BBBSnowball/energy-monitor/energy-meter/energy-meter-brd.pdf

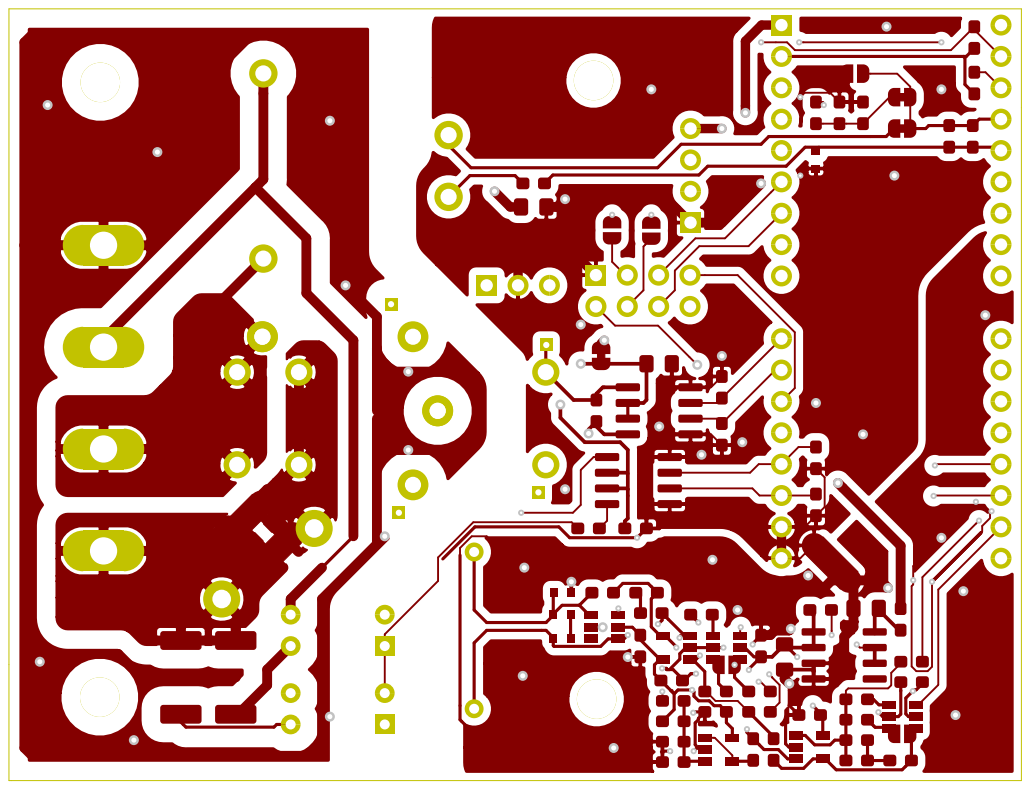
[picture p1: page 1]

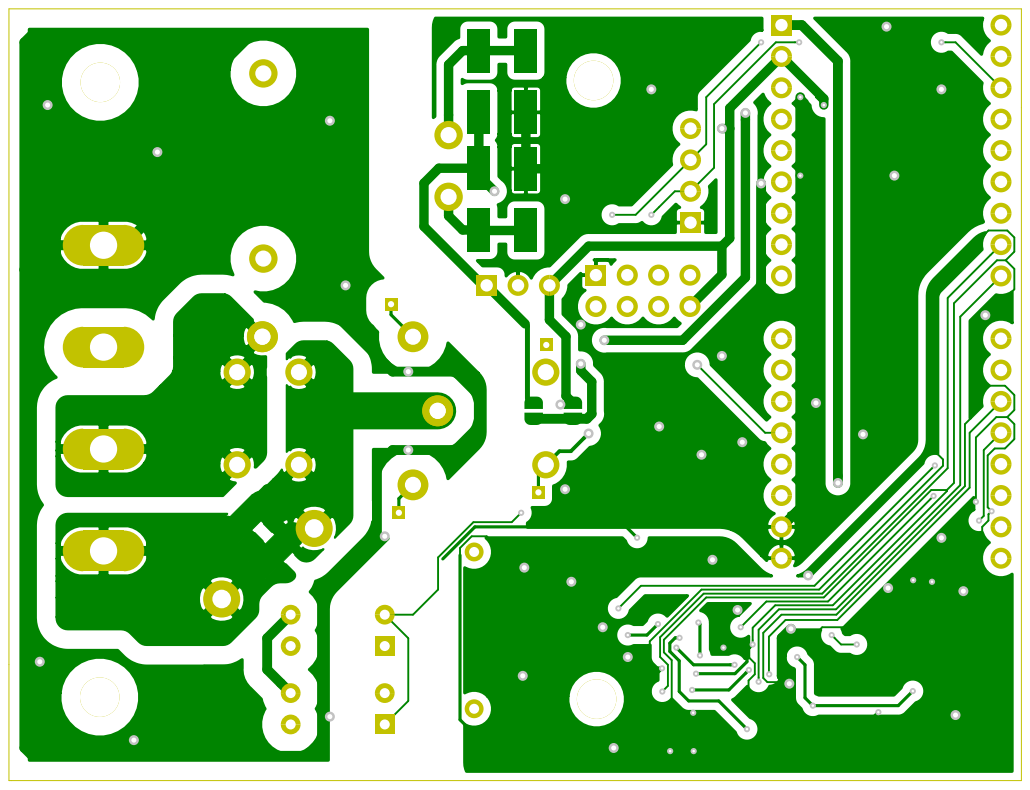
[picture p2: page 2]

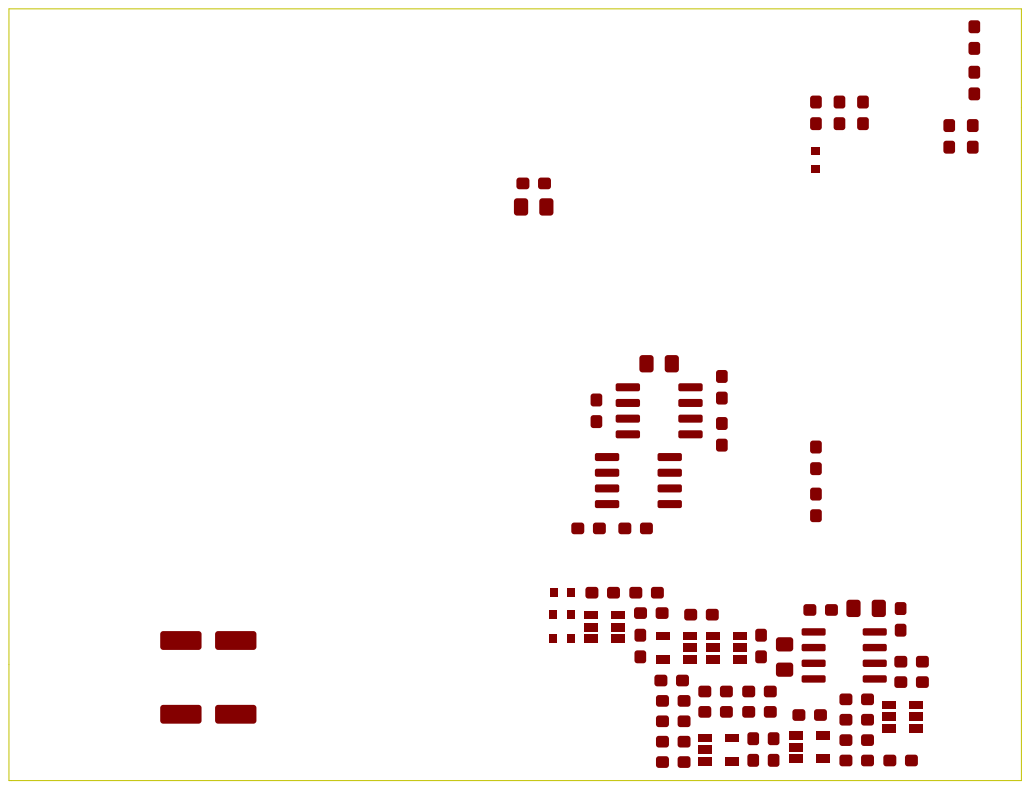
[picture p3: page 3]

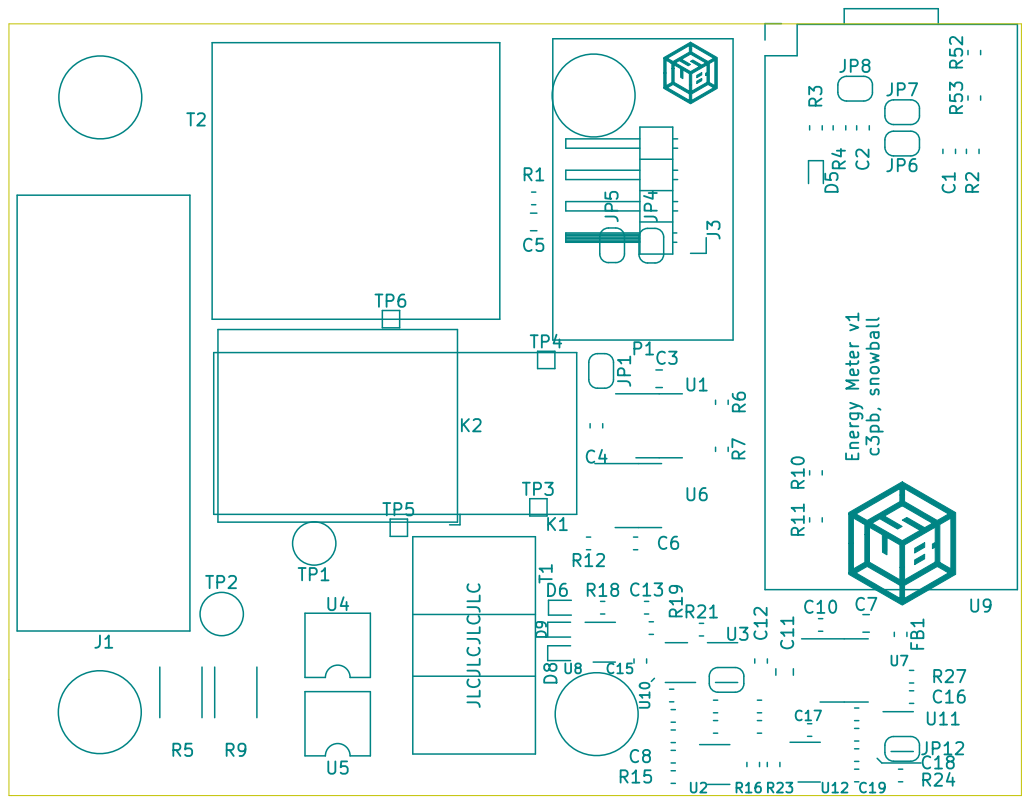
[picture p4: page 5]

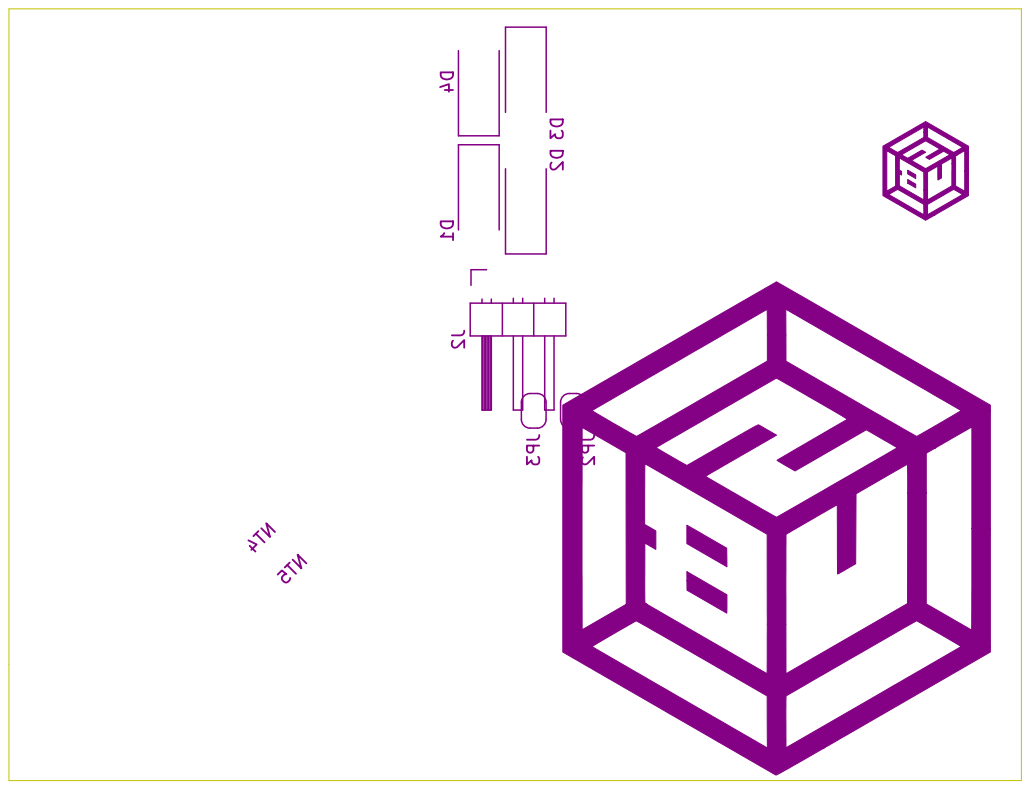
[picture p5: page 6]

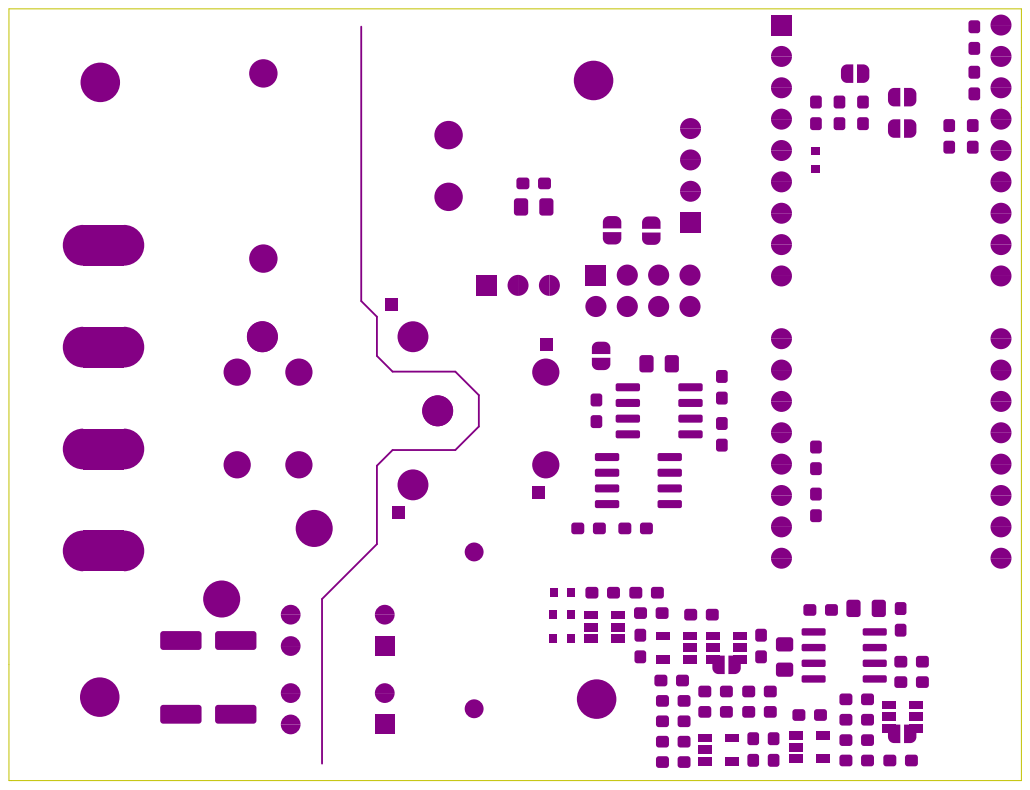
[picture p6: page 7]

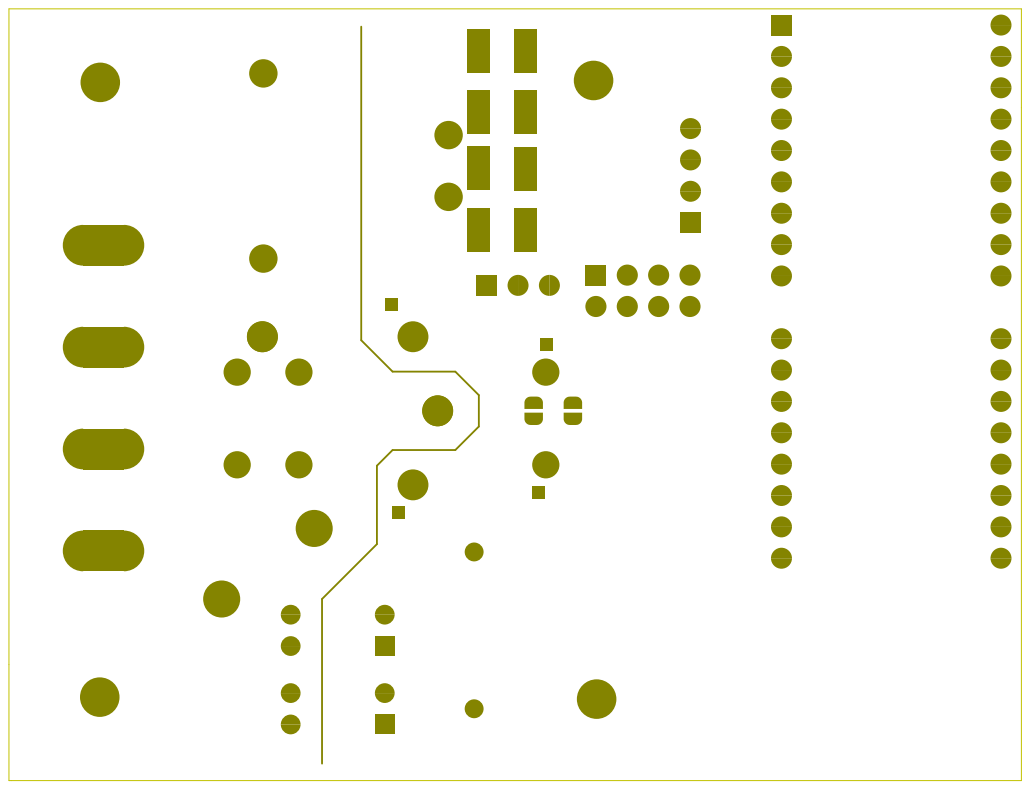
[picture p7: page 8]

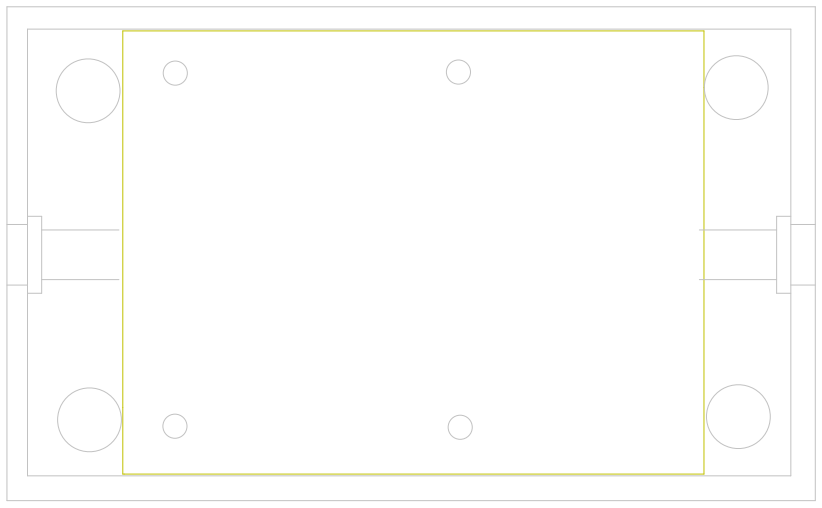
[picture p8: figure]
