BBBSnowball/energy-monitor/energy-meter/LTSpice/Current-Transformer3.asc

C1: cap; 6p
C2: cap; 0
C3: cap; 6p
C4: cap; 12p
I1: current; SINE(0 4u 50); AC 1u
R1: res; 10
R2: res; 10
R3: res; 10k
R4: res; 0
R5: res; 100k
R6: res; 1k
R7: res; 0
U1: AD8628
U2: AD8628
V1: voltage; 3.3
Named nets: VCC, 0, OUT, OUT2, BIAS
;tran 40m
.ac dec 10 1 100Meg
