BBBSnowball/energy-monitor/energy-meter/LTSpice/Current-Transformer.asc

C1: cap; 100n
C2: cap; 100n
C3: cap; 270p
D1: diode; 1N4148
D2: diode; 1N4148
D3: diode; 1N4148
D4: diode; 1N4148
D5: diode; 1N4148
D6: diode; 1N4148
D7: diode; 1N4148
E1: e; 1
E2: e; 1
I1: current; SINE(0 10 50)
I2: current; SINE(0 20 50)
I3: current; SINE(0 435u 50)
I4: current; SINE(0 1u 1k)
L1: ind2; 1n
L2: ind2; 6.25m
L3: ind2; 6.25m
L4: ind2; 1n
L5: ind2; 6.25m
L6: ind2; 1n
L7: ind2; 6.25m
L8: ind2; 1n
L9: ind2; 6.25m; Rser=330
L10: ind2; 1n
L11: ind2; 6.25m
L12: ind2; 1n
L13: ind; 470µ
M1: nmos; AO6408
M2: nmos; AO6408
R1: res; 500
R2: res; 50
R3: res; 50
R4: res; 220
R5: res; 1k
R6: res; 1k
R7: res; 10k
R8: res; 10k
R9: res; 2
R10: res; 0
R11: res; 50
R12: res; 220k
R13: res; 10k
R14: res; 10k
R15: res; 2
R16: res; 0
R17: res; 1Meg
R18: res; 1k
R19: res; 100k
R20: res; 10k
R21: res; 10k
R22: res; 2k
R23: res; 5k
R24: res; 3k
R25: res; 5k
R26: res; 3k
R27: res; 1k
R28: res; 1k
R29: res; 5k
R30: res; 5k
R31: res; 2k
R32: res; 2k
R33: res; 100k
R34: res; 1k
R35: res; 1k
U1: OP07
U2: AD8628
U3: AD8628
U4: ADA4528-1
U5: AD8628
U6: AD8628
U7: AD8628
U8: AD8628
U9: AD8628
V1: voltage; 15
V2: voltage; 15
V3: voltage; 5
V4: voltage; 3.3
V5: voltage; 2.01
V6: voltage; 3.3
V7: voltage; SINE(0 8.5 50)
V8: voltage; PULSE(0 3 0 0.1m 0.1m 9.9m 20m)
V9: voltage; PULSE(0 3 10m 0.1m 0.1m 9.9m 20m)
Named nets: -VCC, +VCC, 0, OUT, OUT2, OUT3, IN3, IN1, +5V, IN3B, OUT4, IN4, +3V3, IN4B, BIAS4, BIAS3, OUT2B, OUT5, IN5, BIAS5, OUT5B, VOUT6A, VOUT6B, VOUT7A, VOUT7B, VCC6, V7A, V7B, VOUT8, OUT5C
K1 L1 L2 1
.tran 100m
K2 L4 L3 1
K3 L6 L5 1
;.OPTIONS GMIN=100F
K4 L8 L7 1
K5 L9 L10 0.5
K6 L12 L11 1
0.1W
Measure voltage when also used for VCC
(not recommended)
use this one
GD32V pin
