BBBSnowball/energy-monitor/energy-meter/LTSpice/Current-Transformer2.asc

C1: cap; 100p
C2: cap; 100n
C3: cap; 270p
I3: current; SINE(0 435u 50)
I4: current; SINE(0 1u 500k)
L11: ind2; 6.25m
L12: ind2; 1n
L13: ind; 470µ
R1: res; 10
R12: res; 220k
R13: res; 10k
R14: res; 10k
R15: res; 2
R16: res; 0
R17: res; 1Meg
R18: res; 1k
R19: res; 100k
R33: res; 100k
R34: res; 1k
R35: res; 1k
U6: AD8628
U7: AD8628
U8: AD8628
V1: voltage; 3.3
V5: voltage; 2.15
Named nets: OUT5, IN5, 0, +3V3, BIAS5, OUT5B, OUT5C
K6 L12 L11 1
0.1W
GD32V pin
.tran 40m
;.ac dec 10 1 1Meg
