BBBSnowball/energy-monitor/energy-meter/energy-meter.kicad_pcb

## KiCad design energy-meter/energy-meter.kicad_pcb (2022-12-10)

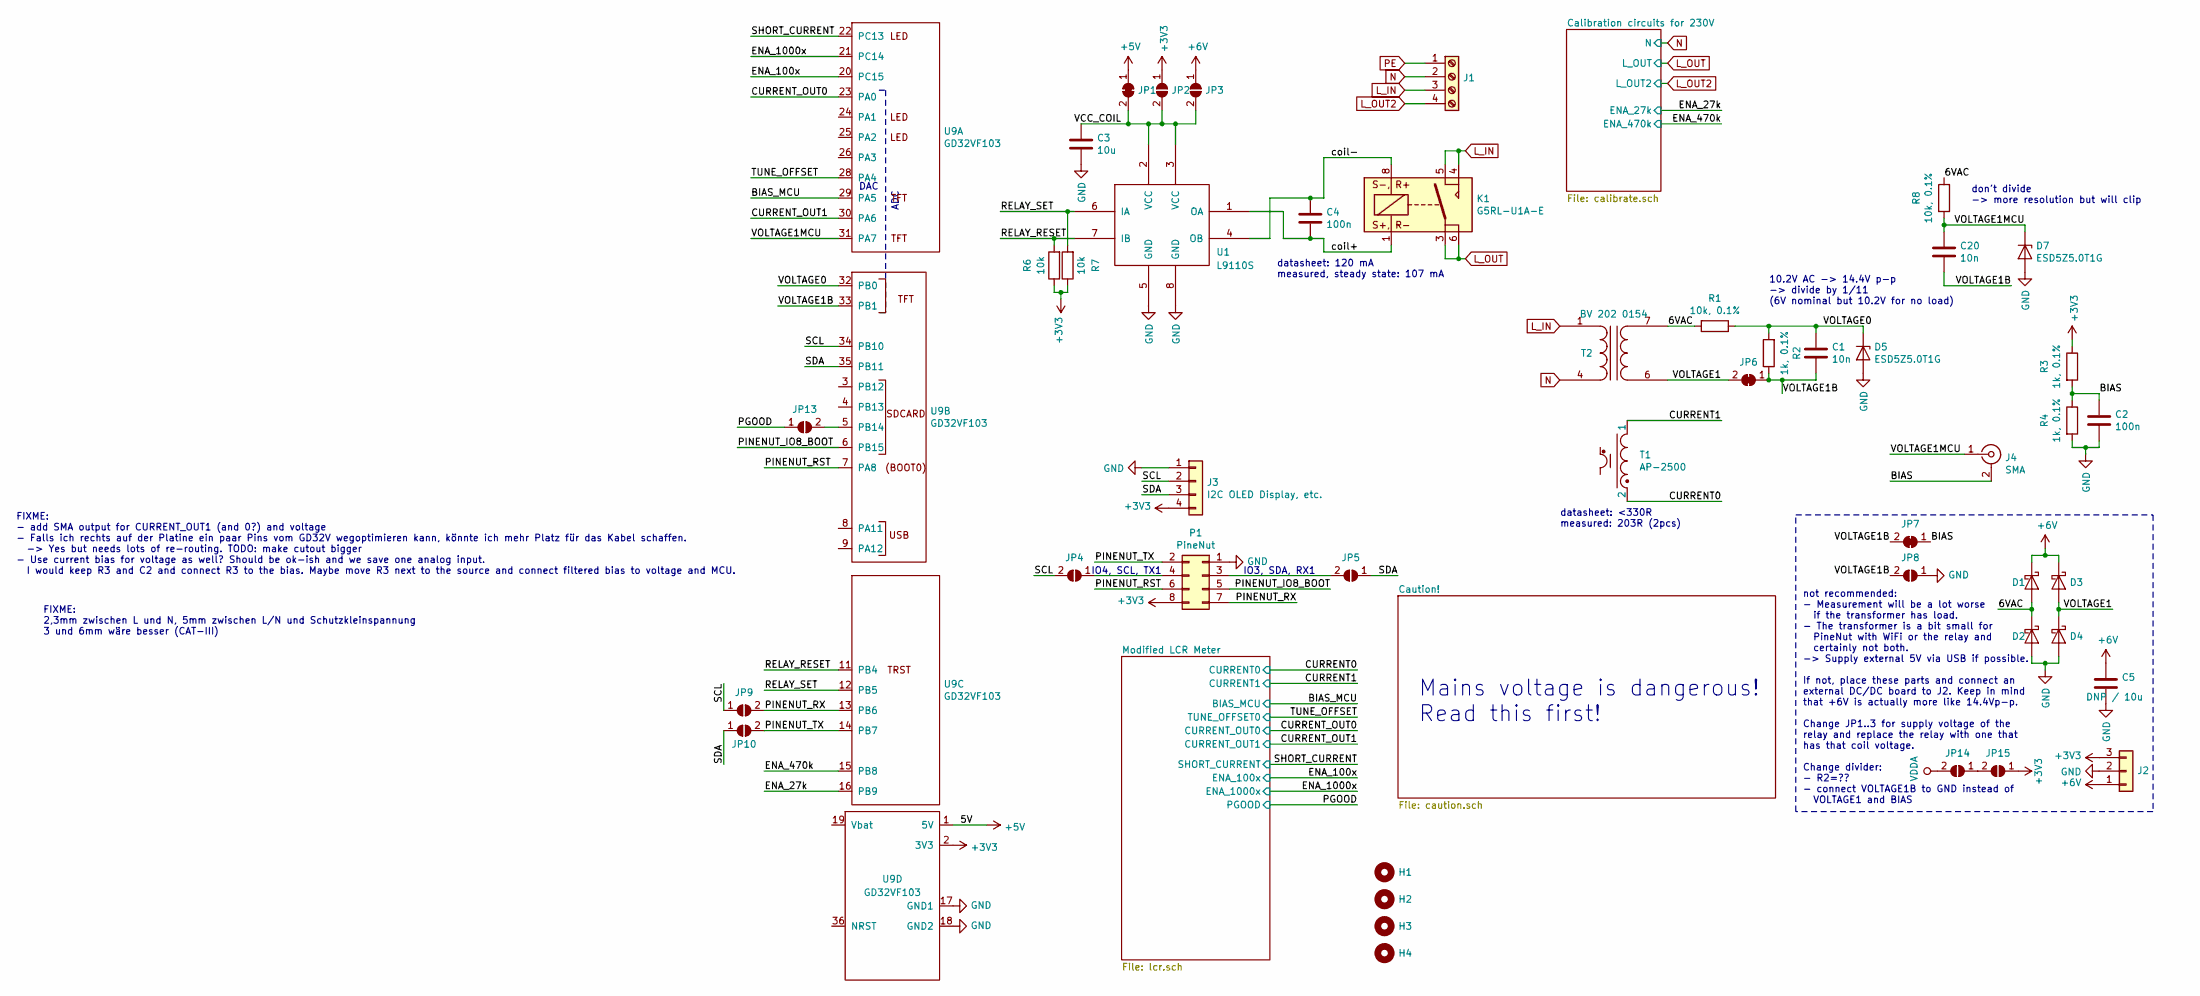
[picture p12: schematic energy-meter.sch]

Parts:
C1, C20: 10n; C_0603_1608Metric_Pad1.05x0.95mm_HandSolder
C2, C4: 100n; C_0603_1608Metric_Pad1.05x0.95mm_HandSolder
C3: 10u; C_0805_2012Metric_Pad1.15x1.40mm_HandSolder; LCSC CL21A106KOQNNNE
C5: DNP / 10u; C_0805_2012Metric_Pad1.15x1.40mm_HandSolder; LCSC CL21A106KOQNNNE
D1, D2, D3, D4: D_Schottky; D_SMA_Handsoldering; LCSC C181203, C364270, C50645
D5, D7: ESD5Z5.0T1G; D_SOD-523
H1, H2, H3, H4: MountingHole_3.2mm_M3; LCSC C63426, C357575, C357368, C357589
J1: Screw_Terminal_01x04; DG35C-B-04P-13-200AH
J2: Conn_01x03; PinHeader_1x03_P2.54mm_Horizontal
J3: I2C OLED Display, etc.; PinHeader_1x04_P2.54mm_Horizontal
J4: SMA; SMA_Samtec_SMA-J-P-H-ST-EM1_EdgeMount; LCSC C496550, C530661, (C1509221)
JP1, JP6, JP7: SolderJumper_2_Bridged; SolderJumper-2_P1.3mm_Bridged_RoundedPad1.0x1.5mm
JP2, JP3, JP4, JP5, JP8, JP9, JP10, JP13, JP14, JP15: SolderJumper_2_Open; SolderJumper-2_P1.3mm_Open_RoundedPad1.0x1.5mm
K1: G5RL-U1A-E
P1: PineNut; Pinenut-01S
R1, R8: 10k, 0.1%; R_0603_1608Metric_Pad1.05x0.95mm_HandSolder
R2, R3, R4: 1k, 0.1%; R_0603_1608Metric_Pad1.05x0.95mm_HandSolder
R6, R7: 10k; R_0603_1608Metric_Pad1.05x0.95mm_HandSolder
T1: AP-2500
T2: BV 202 0154; BV202
U1: L9110S; SOP-8_3.76x4.96mm_P1.27mm; LCSC C725793, C513306, C85174
U9: GD32VF103; GD32VF103CBT6-Sipeed-Longan-Nano

Connections:
+3V3: J2.3, J3.4, JP2.1 (A), JP15.1 (A), P1.8, R3.1, R6.1, R7.1, U9.2 (3V3); also elsewhere on the board
+5V: JP1.1 (A), U9.1 (5V); also elsewhere on the board
+6V: C5.1, D1.1 (K), D3.1 (K), J2.1, JP3.1 (A)
/6VAC: D1.2 (A), D2.1 (K), R1.2, R8.1, T2.7 (SB)
/BIAS: C2.1, J4.2 (Ext), JP7.1 (A), R3.2, R4.1
/BIAS_MCU: U9.29 (PA5); also elsewhere on the board
/CURRENT0: T1.2; also elsewhere on the board
/CURRENT1: T1.1; also elsewhere on the board
/CURRENT_OUT0: U9.23 (PA0); also elsewhere on the board
/CURRENT_OUT1: U9.30 (PA6); also elsewhere on the board
/ENA_27k: U9.16 (PB9); also elsewhere on the board
/ENA_100x: U9.20 (PC15); also elsewhere on the board
/ENA_470k: U9.15 (PB8); also elsewhere on the board
/ENA_1000x: U9.21 (PC14); also elsewhere on the board
/PGOOD: JP13.1 (A); also elsewhere on the board
/PINENUT_IO8_BOOT: P1.5, U9.6 (PB15)
/PINENUT_RST: P1.6, U9.7 (PA8)
/PINENUT_RX: JP9.2 (B), P1.7, U9.13 (PB6)
/PINENUT_TX: JP10.2 (B), P1.2, U9.14 (PB7)
/RELAY_RESET: R6.2, U1.7 (IB), U9.11 (PB4)
/RELAY_SET: R7.2, U1.6 (IA), U9.12 (PB5)
/SCL: J3.2, JP4.2 (B), JP9.1 (A), U9.34 (PB10); also elsewhere on the board
/SDA: J3.3, JP5.1 (A), JP10.1 (A), U9.35 (PB11); also elsewhere on the board
/SHORT_CURRENT: U9.22 (PC13); also elsewhere on the board
/TUNE_OFFSET: U9.28 (PA4); also elsewhere on the board
/VCC_COIL: C3.1, JP1.2 (B), JP2.2 (B), JP3.2 (B), U1.2 (VCC), U1.3 (VCC)
/VOLTAGE0: C1.1, D5.1 (K), R1.1, R2.2, U9.32 (PB0)
/VOLTAGE1: D3.2 (A), D4.1 (K), JP6.2 (B), T2.6 (SA)
/VOLTAGE1B: C1.2, C20.2, JP6.1 (A), JP7.2 (B), JP8.2 (B), R2.1, U9.33 (PB1)
/VOLTAGE1MCU: C20.1, D7.1 (K), J4.1 (In), R8.2, U9.31 (PA7)
/coil+: C4.2, K1.1, U1.1 (OA)
/coil-: C4.1, K1.8, U1.4 (OB)
GND: C2.2, C3.2, C5.2, D2.2 (A), D4.2 (A), D5.2 (A), D7.2 (A), J2.2, J3.1, JP8.1 (A), P1.1, R4.2, U1.5 (GND), U1.8 (GND), U9.17 (GND1), U9.18 (GND2); also elsewhere on the board
L_IN: J1.3, K1.4, K1.5, T2.1 (AA)
L_OUT: K1.3, K1.6; also elsewhere on the board
L_OUT2: J1.4; also elsewhere on the board
N: J1.2, T2.4 (AB); also elsewhere on the board
unnamed: JP4.1 (A), P1.4
unnamed: JP5.2 (B), P1.3
unnamed: JP13.2 (B), U9.5 (PB14)
unnamed: JP14.1 (A), JP15.2 (B)
PE: J1.1
VDDA: JP14.2 (B); also elsewhere on the board

Notes on the sheet:
ADC
IO3, SDA, RX1
IO4, SCL, TX1
10.2V AC -> 14.4V p-p -> divide by 1/11 (6V nominal but 10.2V for no load)
not recommended: - Measurement will be a lot worse if the transformer has load. - The transformer is a bit small for PineNut with WiFi or the relay and certainly not both. -> Supply external 5V via USB if possible. If not, place these parts and connect an external DC/DC board to J2. Keep in mind th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
DAC
datasheet: 120 mA measured, steady state: 107 mA
datasheet: <330R measured: 203R (2pcs)
Mains voltage is dangerous! Read this first!
don't divide -> more resolution but will clip
FIXME: - add SMA output for CURRENT_OUT1 (and 0?) and voltage - Falls ich rechts auf der Platine ein paar Pins vom GD32V wegoptimieren kann, könnte ich mehr Platz für das Kabel schaffen. -> Yes but needs lots of re-routing. TODO: make cutout bigger - Use current bias for voltage as well? Should be 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
FIXME: 2,3mm zwischen L und N, 5mm zwischen L/N und Schutzkleinspannung 3 und 6mm wäre besser (CAT-III)

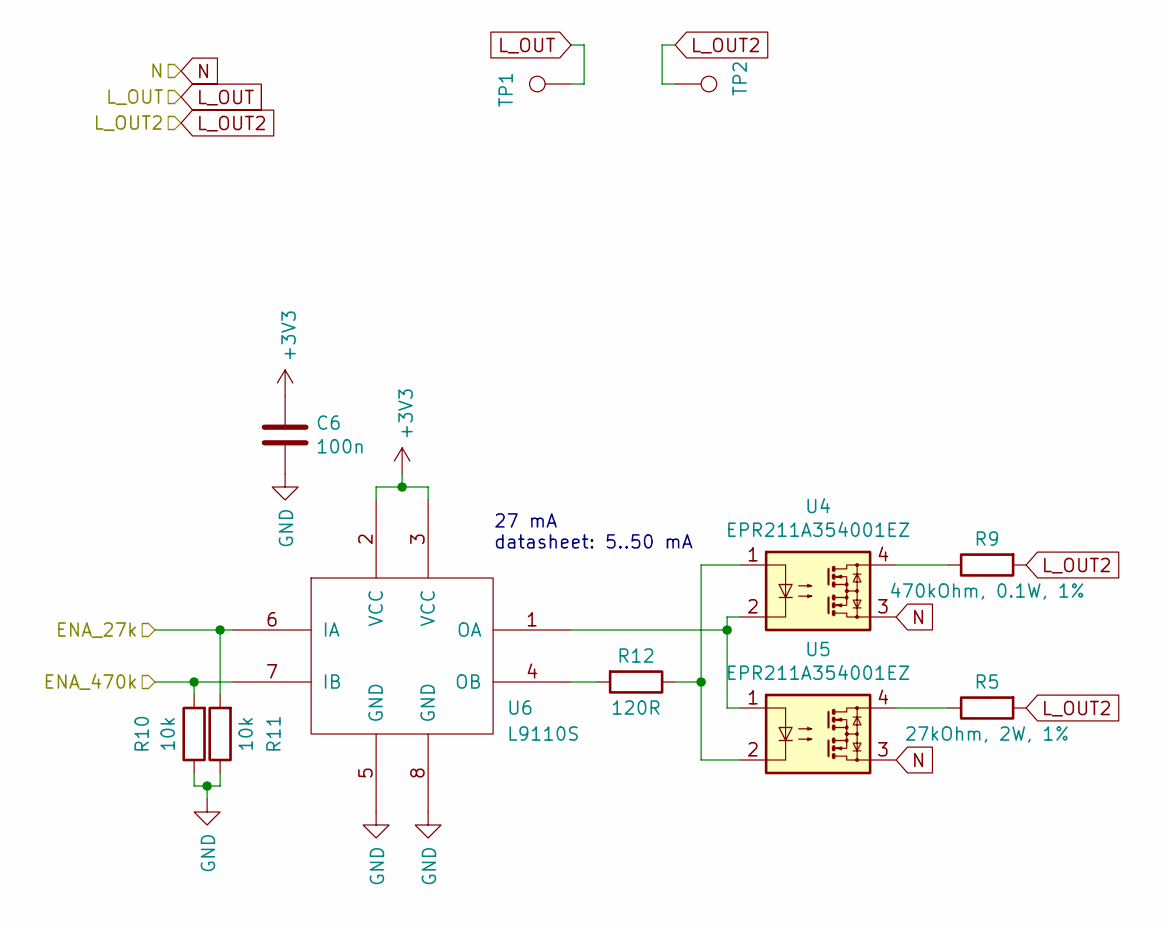
[picture p13: schematic calibrate.sch]

Parts:
C6: 100n; C_0603_1608Metric_Pad1.05x0.95mm_HandSolder
R5: 27kOhm, 2W, 1%; R_2512_6332Metric_Pad1.52x3.35mm_HandSolder
R9: 470kOhm, 0.1W, 1%; R_2512_6332Metric_Pad1.52x3.35mm_HandSolder
R10, R11: 10k; R_0603_1608Metric_Pad1.05x0.95mm_HandSolder
R12: 120R; R_0603_1608Metric_Pad1.05x0.95mm_HandSolder
TP1, TP2: TestPoint; TestPoint_THTPad_D4.0mm_Drill2.0mm
U4, U5: EPR211A354001EZ; DIP-4_W7.62mm
U6: L9110S; SOP-8_3.76x4.96mm_P1.27mm; LCSC C725793, C513306, C85174

Connections:
+3V3: C6.1, U6.2 (VCC), U6.3 (VCC); also elsewhere on the board
/ENA_27k: R11.2, U6.6 (IA); also elsewhere on the board
/ENA_470k: R10.2, U6.7 (IB); also elsewhere on the board
GND: C6.2, R10.1, R11.1, U6.5 (GND), U6.8 (GND); also elsewhere on the board
L_OUT: TP1.1; also elsewhere on the board
L_OUT2: R5.2, R9.2, TP2.1; also elsewhere on the board
N: U4.3, U5.3; also elsewhere on the board
unnamed: R5.1, U5.4
unnamed: R9.1, U4.4
unnamed: R12.1, U4.1, U5.2
unnamed: R12.2, U6.4 (OB)
unnamed: U4.2, U5.1, U6.1 (OA)

Notes on the sheet:
27 mA datasheet: 5..50 mA

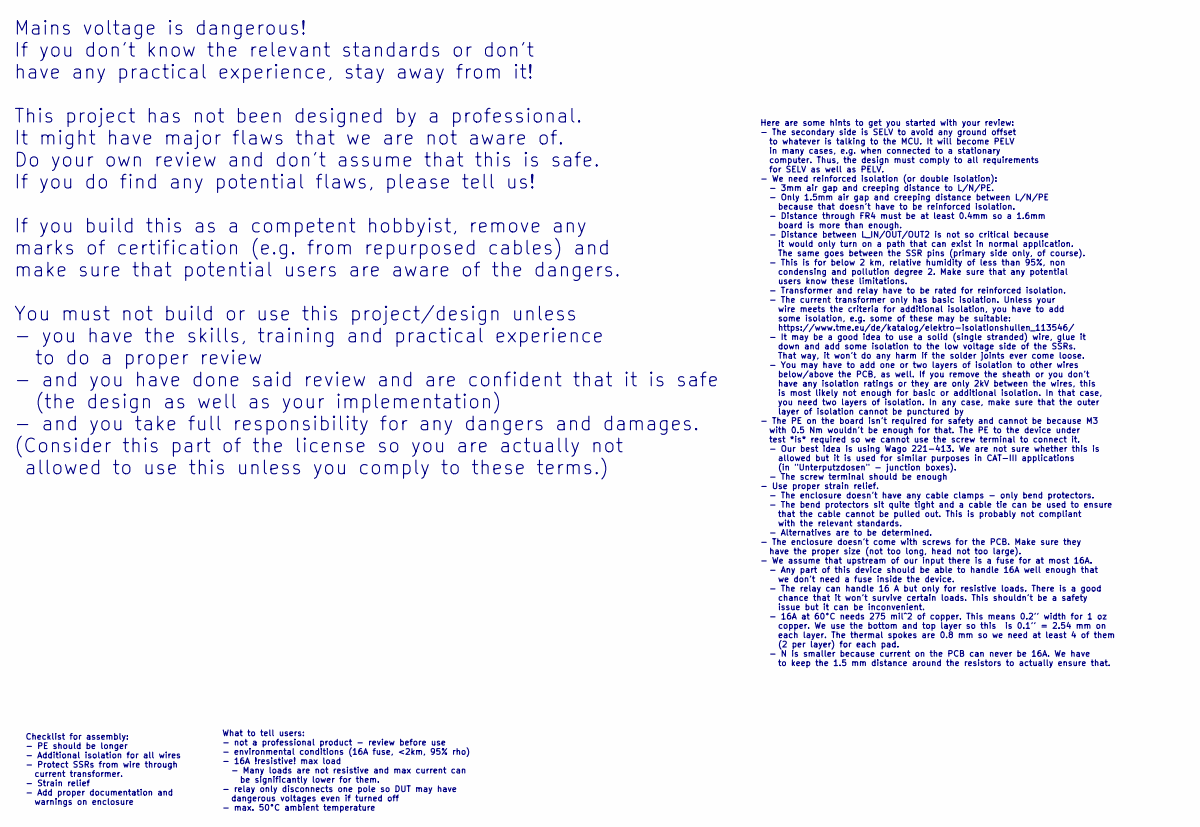
[picture p14: schematic caution.sch]

Notes on the sheet:
Mains voltage is dangerous! If you don't know the relevant standards or don't have any practical experience, stay away from it! This project has not been designed by a professional. It might have major flaws that we are not aware of. Do your own review and don't assume that this is safe. If you do 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
Here are some hints to get you started with your review: - The secondary side is SELV to avoid any ground offset to whatever is talking to the MCU. It will become PELV in many cases, e.g. when connected to a stationary computer. Thus, the design must comply to all requirements for SELV as well as P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
Checklist for assembly: - PE should be longer - Additional isolation for all wires - Protect SSRs from wire through current transformer. - Strain relief - Add proper documentation and warnings on enclosure
What to tell users: - not a professional product - review before use - environmental conditions (16A fuse, <2km, 95% rho) - 16A !resistive! max load - Many loads are not resistive and max current can be significantly lower for them. - relay only disconnects one pole so DUT may have dangerous voltag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

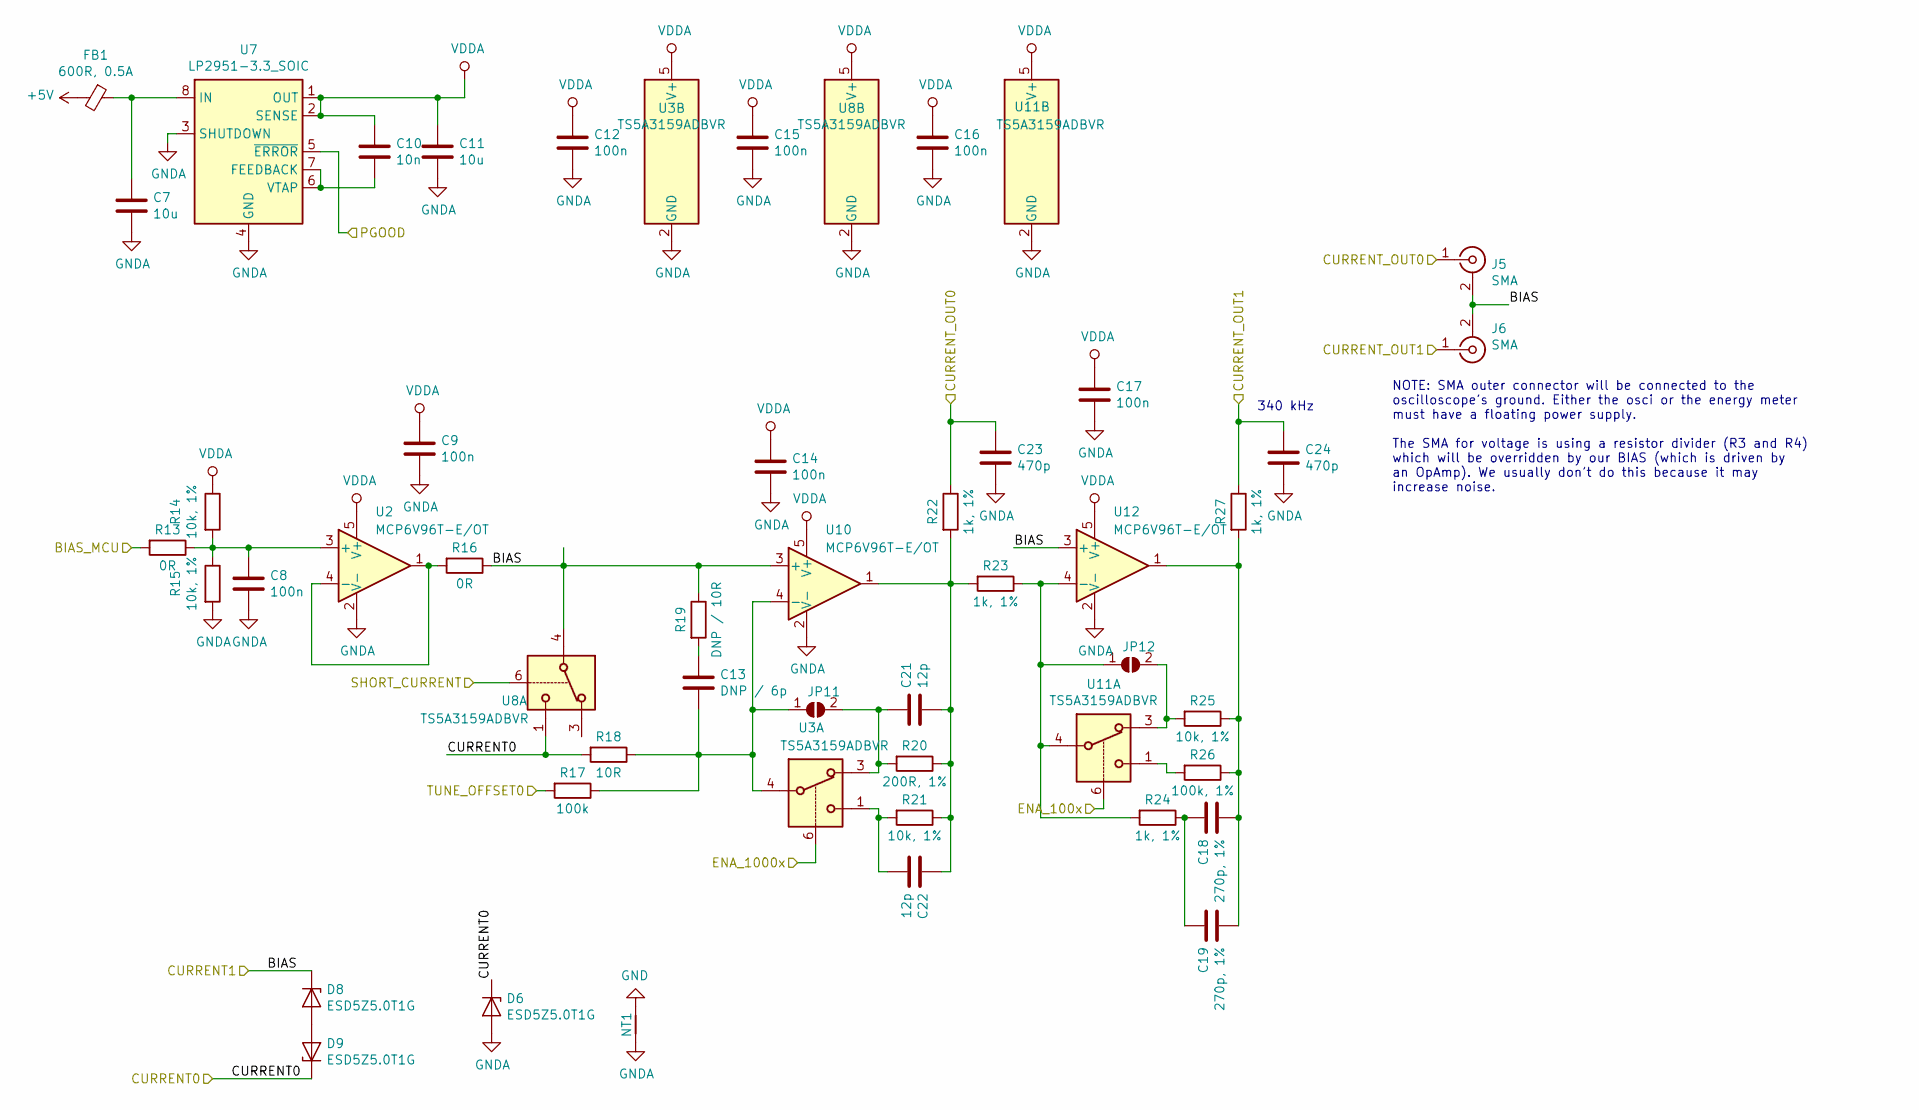
[picture p15: schematic lcr.sch]

Parts:
C7, C11: 10u; C_0805_2012Metric_Pad1.15x1.40mm_HandSolder; LCSC CL21A106KOQNNNE
C8, C9, C12, C14, C15, C16, C17: 100n; C_0603_1608Metric_Pad1.05x0.95mm_HandSolder
C10: 10n; C_0603_1608Metric_Pad1.05x0.95mm_HandSolder
C13: DNP / 6p; C_0603_1608Metric_Pad1.05x0.95mm_HandSolder
C18, C19: 270p, 1%; C_0603_1608Metric_Pad1.05x0.95mm_HandSolder
C21, C22: 12p; C_0603_1608Metric_Pad1.05x0.95mm_HandSolder
C23, C24: 470p; C_0603_1608Metric_Pad1.05x0.95mm_HandSolder
D6, D8, D9: ESD5Z5.0T1G; D_SOD-523
FB1: 600R, 0.5A; L_0603_1608Metric_Pad1.05x0.95mm_HandSolder; MPN BLM15PX601SZ1D
J5, J6: SMA; SMA_Samtec_SMA-J-P-H-ST-EM1_EdgeMount; LCSC C496550, C530661, (C1509221)
JP11, JP12: SolderJumper_2_Open; SolderJumper-2_P1.3mm_Open_RoundedPad1.0x1.5mm
NT1: Net-Tie_2; NetTie-2_SMD_Pad2.0mm
R13, R16: 0R; R_0603_1608Metric_Pad1.05x0.95mm_HandSolder
R14, R15, R21, R25: 10k, 1%; R_0603_1608Metric_Pad1.05x0.95mm_HandSolder
R17: 100k; R_0603_1608Metric_Pad1.05x0.95mm_HandSolder
R18: 10R; R_0603_1608Metric_Pad1.05x0.95mm_HandSolder
R19: DNP / 10R; R_0603_1608Metric_Pad1.05x0.95mm_HandSolder
R20: 200R, 1%; R_0603_1608Metric_Pad1.05x0.95mm_HandSolder
R22, R23, R24, R27: 1k, 1%; R_0603_1608Metric_Pad1.05x0.95mm_HandSolder
R26: 100k, 1%; R_0603_1608Metric_Pad1.05x0.95mm_HandSolder
U2, U10, U12: MCP6V96T-E/OT; SOT-23-5
U3, U8, U11: TS5A3159ADBVR; SOT-23-6
U7: LP2951-3.3_SOIC; SOIC-8_3.9x4.9mm_P1.27mm

Connections:
+5V: FB1.2; also elsewhere on the board
/BIAS_MCU: R13.2; also elsewhere on the board
/CURRENT0: D6.1 (K), D9.1 (K), R18.2, U8.1; also elsewhere on the board
/CURRENT1: D8.1 (K), J5.2 (Ext), J6.2 (Ext), R16.1, R19.1, U8.4, U10.3 (+), U12.3 (+); also elsewhere on the board
/CURRENT_OUT0: C23.1, J5.1 (In), R22.1; also elsewhere on the board
/CURRENT_OUT1: C24.1, J6.1 (In), R27.1; also elsewhere on the board
/ENA_100x: U11.6; also elsewhere on the board
/ENA_1000x: U3.6; also elsewhere on the board
/PGOOD: U7.5 (~ERROR); also elsewhere on the board
/SHORT_CURRENT: U8.6; also elsewhere on the board
/TUNE_OFFSET: R17.2; also elsewhere on the board
GND: NT1.1; also elsewhere on the board
GNDA: C7.2, C8.2, C9.2, C11.2, C12.2, C14.2, C15.2, C16.2, C17.2, C23.2, C24.2, D6.2 (A), NT1.2, R15.2, U2.2 (V-), U3.2 (GND), U7.3 (SHUTDOWN), U7.4 (GND), U8.2 (GND), U10.2 (V-), U11.2 (GND), U12.2 (V-)
unnamed: C7.1, FB1.1, U7.8 (IN)
unnamed: C8.1, R13.1, R14.2, R15.1, U2.3 (+)
unnamed: C10.2, U7.6 (VTAP), U7.7 (FEEDBACK)
unnamed: C13.1, R19.2
unnamed: C13.2, JP11.1 (A), R17.1, R18.1, U3.4, U10.4 (-)
unnamed: C18.1, C19.1, R24.1
unnamed: C18.2, C19.2, R25.1, R26.1, R27.2, U12.1
unnamed: C21.1, JP11.2 (B), R20.2, U3.3
unnamed: C21.2, C22.1, R20.1, R21.1, R22.2, R23.2, U10.1
unnamed: C22.2, R21.2, U3.1
unnamed: D8.2 (A), D9.2 (A)
unnamed: JP12.1 (A), R23.1, R24.2, U11.4, U12.4 (-)
unnamed: JP12.2 (B), R25.2, U11.3
unnamed: R16.2, U2.1, U2.4 (-)
unnamed: R26.2, U11.1
VDDA: C9.1, C10.1, C11.1, C12.1, C14.1, C15.1, C16.1, C17.1, R14.1, U2.5 (V+), U3.5 (V+), U7.1 (OUT), U7.2 (SENSE), U8.5 (V+), U10.5 (V+), U11.5 (V+), U12.5 (V+); also elsewhere on the board

Notes on the sheet:
340 kHz
NOTE: SMA outer connector will be connected to the oscilloscope's ground. Either the osci or the energy meter must have a floating power supply. The SMA for voltage is using a resistor divider (R3 and R4) which will be overridden by our BIAS (which is driven by an OpAmp). We usually don't do this b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

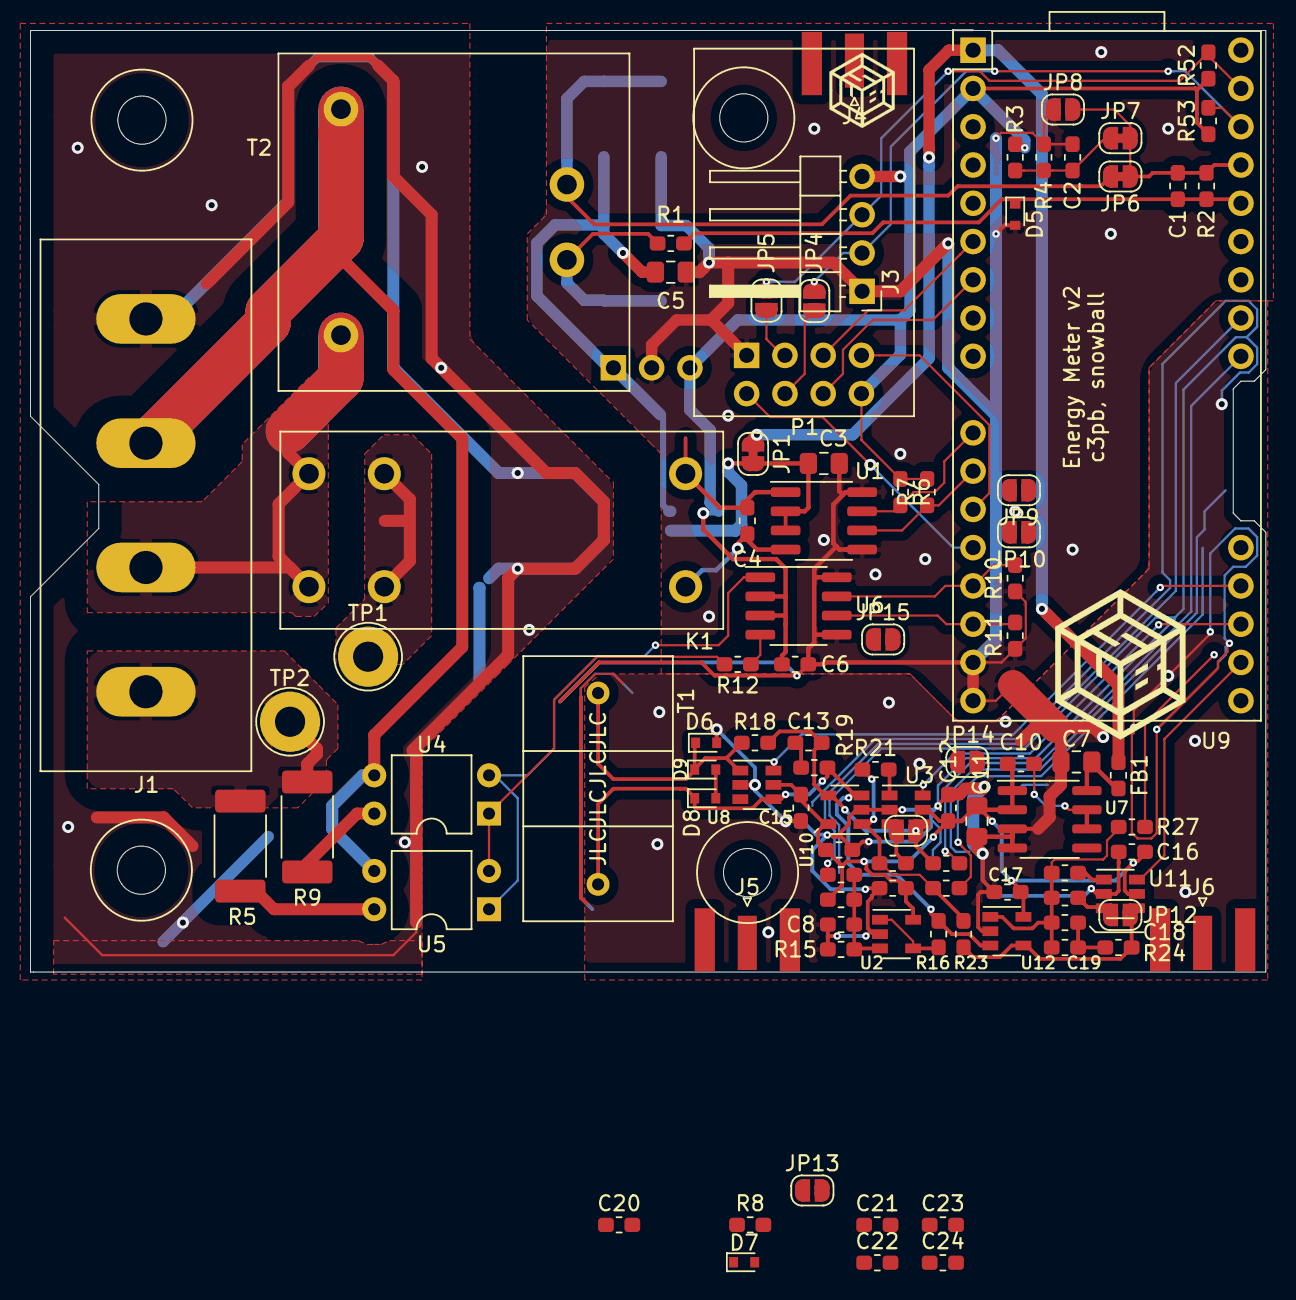
[picture p16: board energy-meter.kicad_pcb from above]

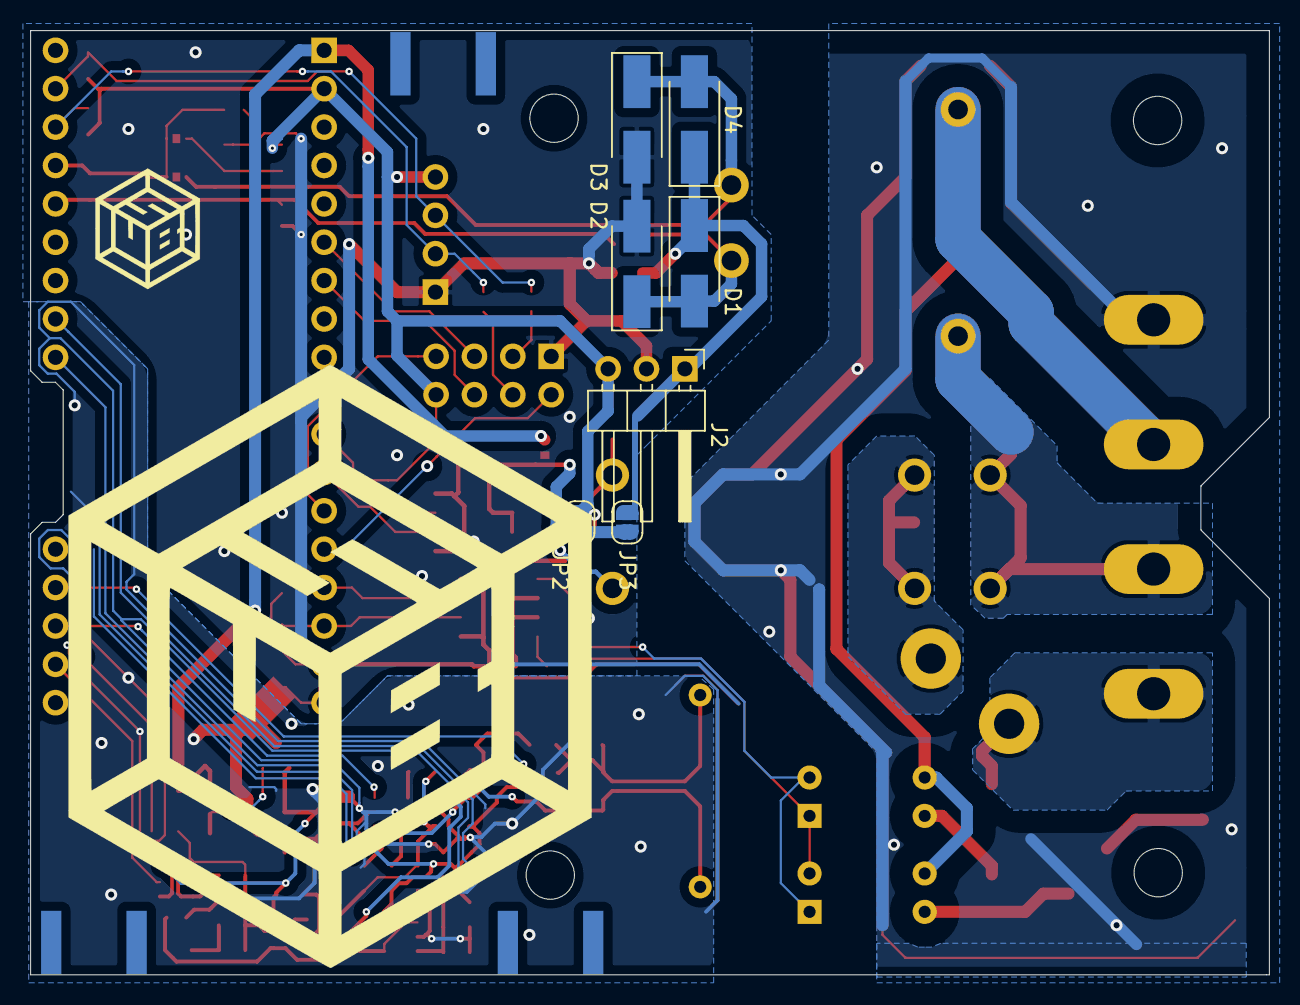
[picture p17: board energy-meter.kicad_pcb from below]

Board: 2 copper layers, 82.0 x 62.5 mm, 107 parts (7 on the bottom side), 63 nets.

Other parts of the board:
R52, R53: 10k; R_0603_1608Metric_Pad1.05x0.95mm_HandSolder

Their connections:
+3V3: R52.1, R53.1; also elsewhere on the board
/SCL: R53.2; also elsewhere on the board
/SDA: R52.2; also elsewhere on the board
