BBBSnowball/energy-monitor/(commit log)

2021-04-17 continue changing schematic
    [energy-meter.kicad_pcb, energy-meter.sch, lcr.sch]
2021-04-17 remove two of the opamps
    We can measure the voltage without an amplifier so let's do it. The other
    was used for the LCR outputs, which we don't have here.
    [energy-meter.kicad_pcb, energy-meter.sch, lcr.sch, lcr2.sch]
2021-04-17 everything done except current measurement
    [energy-meter.kicad_pcb, energy-meter.sch, lcr.sch, lcr2.sch]
2021-04-17 DRC, add header for I2C
    [energy-meter.kicad_pcb, energy-meter.sch, lcr.sch]
2021-04-17 add alternative relay
    [energy-meter.kicad_pcb, energy-meter.sch]
2021-04-17 move some text
    [energy-meter.kicad_pcb]
2021-04-17 add optional internal load resistor
    This may be useful for calibration and tests.
    [energy-meter.kicad_pcb, energy-meter.sch]
2021-04-17 2nd relay needs an additional driver if we want to use both of them
    [energy-meter.kicad_pcb, energy-meter.sch, lcr.sch]
2021-04-17 add some vias for PE
    [energy-meter.kicad_pcb]
2021-04-18 adjust voltage divider to somewhat work if transformer is also used for VCC
    In that case, we will only see one half of the wave.
    [energy-meter.kicad_pcb, energy-meter.sch, lcr.sch]
2021-04-18 use solid state relays for calibration
    That way, we have enough space for two of them. The alternative relay
    shares space with the other relay because only one of them will be used.
    [calibrate.sch, energy-meter.kicad_pcb, energy-meter.sch, lcr.sch]
2021-04-18 add opamps
    [calibrate.sch, energy-meter.kicad_pcb, energy-meter.sch, lcr.sch]
2021-04-18 add logos, increase distance to SELV, add PDFs and Gerbers
    Lot's of whitespace changes, unfortunately.
    [calibrate.sch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]
2021-06-08 try capacitor in feedback of transimpedance amplifier -> seems to be a good idea
2021-06-08 add small circuit for measuring 230V with a Red Pitaya
    [oszi-230V.kicad_pcb, oszi-230V.sch]
2021-06-08 open files on Windows, add comment
    [calibrate.sch, energy-meter.sch, lcr.sch]
2021-06-09 add sheet with warnings and design info
    [calibrate.sch, caution.sch, energy-meter.sch, lcr.sch]
2021-06-09 remove optional parts, increase distance between conductors on primary side
    [calibrate.sch, energy-meter.kicad_pcb, energy-meter.sch]
2021-06-09 increase size of test points for wire through current transformer, unswap RELAY_SET/RESET
    [calibrate.sch, energy-meter.kicad_pcb, energy-meter.sch]
2021-06-09 handle most TODOs in schematic, PCB to be done
    [calibrate.sch, energy-meter.kicad_pcb, energy-meter.sch, lcr.sch]
2022-12-10 old changes
    [energy-meter.kicad_pcb, energy-meter.sch, lcr.sch]
2022-12-10 fix two incomplete sentences
    [caution.sch]
